andkorzh/FPGA-DENDY-SE/README.md

# FPGA-DENDY-SE
A clock-precise FPGA design for an 8-bit game console.
A simplified version of the 8-bit FPGA gaming console based on the Cyclone I EP1C3T100C8. It supports composite video output (composite encoder by NardWareMan) and optional RGB with an additional expansion board. Audio output is provided via PWM modulators.

SE_PCB

fpga_dendy_SE1

fpga_dendy_SE2

FPGA resources

se_res

video on YouTube: https://www.youtube.com/watch?v=lXBCwr5WWws
