andkorzh/FPGA-DENDY-SE/PCB/FPGA_DENDY SE.png

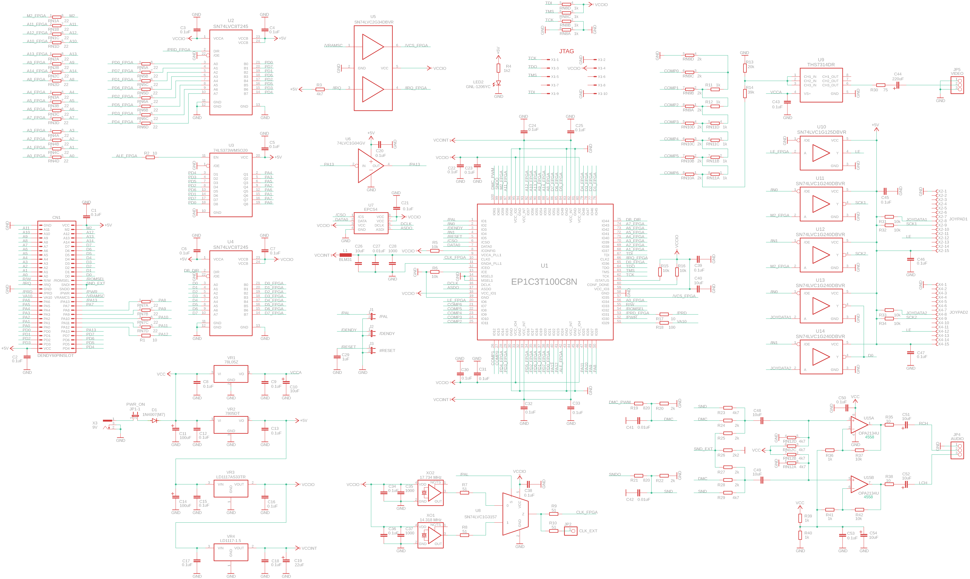
PCB/FPGA_DENDY SE.png
