andkorzh/FPGA-DENDY-SE/PCB/BOM FPGA_DENDY SE.xlsx

POS | Q-ty | VALUE | manufacturer | package | PART NUM | SIMILAR
 | 1 | EP1C3T100C8N | Altera INTEL | TQFP100 | EP1C3T100C8N | EP1C3T100I8N
 | 1 | EPCS4SI8N | Altera INTEL | SOIC-8 | EPCS4SI8N | W25X40CLSNIG
 | 2 | SN74LVC8T245PWR | TI | TSSOP-24 | SN74LVC8T245PWR | SN74LVC4245APWR
 | 1 | SN74LS373DW | TI | soic-20(7.5мм) | SN74LS373DW
 | 4 | SN74LVC1G240DBVR | TI | SOT-23-5 | SN74LVC1G240DBVR
 | 1 | SN74LVC1G125DBVR | TI | SOT-23-5 | SN74LVC1G125DBVR
 | 1 | SN74LVC1G04DBVR | TI | SOT-23-5 | SN74LVC1G04DBVR
 | 1 | SN74LVC2G34DBVR | TI | SOT-23-6 | SN74LVC2G34DBVR
 | 1 | SN74LVC1G3157DBVR | TI | SOT-23-6 | SN74LVC1G3157DBVR
 | 1 | THS7314DR | TI | SOIC-8 | THS7314DR
 | 1 | BA4558F-E2 | Rohm | SOIC-8 | BA4558F-E2
 | 1 | UMW 78M05 | UMW | DPAK/TO-252 | UMW 78M05
 | 1 | AMS1117-1.5 | UMW | SOT-223 | AMS1117-1.5 | LD1117-1.5
 | 1 | LD1117AS33TR | STM | SOT-223 | LD1117AS33TR
 | 1 | 78L05 | TI | TO-92 | LM78L05ACZ/NOPB
 | 1 | SMA4007 | UMW | DO-214AC/SMA | 1N4007(M7)
 | 1 | crystal oscillator 14.318MHz |  | 7050
 | 1 | crystal oscillator 17.734MHz |  | 7050
 | 1 | GNL-1206YC | G-nor Electronics | 1206 | GNL-1206YC | any 1206 SMD LED (YELLOW)
 | 2 | 4х1kΩ1% | Bourns | 0603x4 | CAT16-102J4LF
 | 2 | 4х2kΩ1% | Bourns | 0603x4 | CAT16-202J4LF
 | 7 | 4х22Ω1% | Bourns | 0603x4 | CAT16-22R0F4LF
 | 1 | 4х4k7kΩ5% | Bourns | 0603x4 | CAT16-472J4LF
 | 1 | 75Ω±5% | YAGEO | 0603 | RC0603JR-0775RL
 | 4 | 51Ω±5% | YAGEO | 0603 | RC0603JR-0751RL
 | 5 | 10Ω±5% | YAGEO | 0603 | RC0603JR-0710RL
 | 1 | 1,2kΩ±5% | YAGEO | 0603 | RC0603JR-071K2L
 | 1 | 2,2kΩ±1% | KOA Speer | 0603 | SG73P1JTTD2201F
 | 6 | 2kΩ±1% | KOA Speer | 0603 | RK73G1JTTD2001F
 | 6 | 1kΩ±1% | KOA Speer | 0603 | RK73G1JTTD1001F
 | 1 | 20kΩ±1% | KOA Speer | 0603 | RK73H1JTTD2002F
 | 1 | 39kΩ±1% | KOA Speer | 0603 | RK73H1JTTD3902F
 | 3 | 4,7kΩ±5% | YAGEO | 0603 | RC0603JR-074K7L
 | 10 | 10kΩ±5% | YAGEO | 0603 | RC0603JR-0710KL
 | 2 | 820Ω±1% | KOA Speer | 0603 | RK73H1JTTD8200F
 | 1 | 100Ω±5% | YAGEO | 0603 | RC0603JR-07100RL
 | 1 | 1uF X7R 16V 10% | Murata | 0603 | GRM188R71C105KA12D
 | 36 | 0.1uF X7R 16V 10% | Murata | 0603 | GRM188R71C104KA01D
 | 3 | 0.01uF X7R 16V 10% | Murata | 0603 | GRM1885C1H103JA01D
 | 3 | 1000pF NP0 50V 5% 0603 | Murata | 0603 | GRM1885C1H102J
 | 9 | 10uF X7R 10% 25V 1210, | Murata | 1210 | GRM32DR71E106KA12L
 | 2 | 100uF, 16v, 105°C, 20% ECAP SMD, 6.3x5.4мм, | JB cap | 6.3x5.4 | JCK1C101M063054
 | 1 | KLS1-DC-005A-2.0 | KLS electronic co ltd | 2,1х5.5x9mm | L-KLS1-DC-005A-2.0
