andkorzh/FPGA-DENDY-SE/PCB/FPGA_DENDY_SE.sch

## EAGLE design PCB/FPGA_DENDY_SE.sch (2026-10-07)

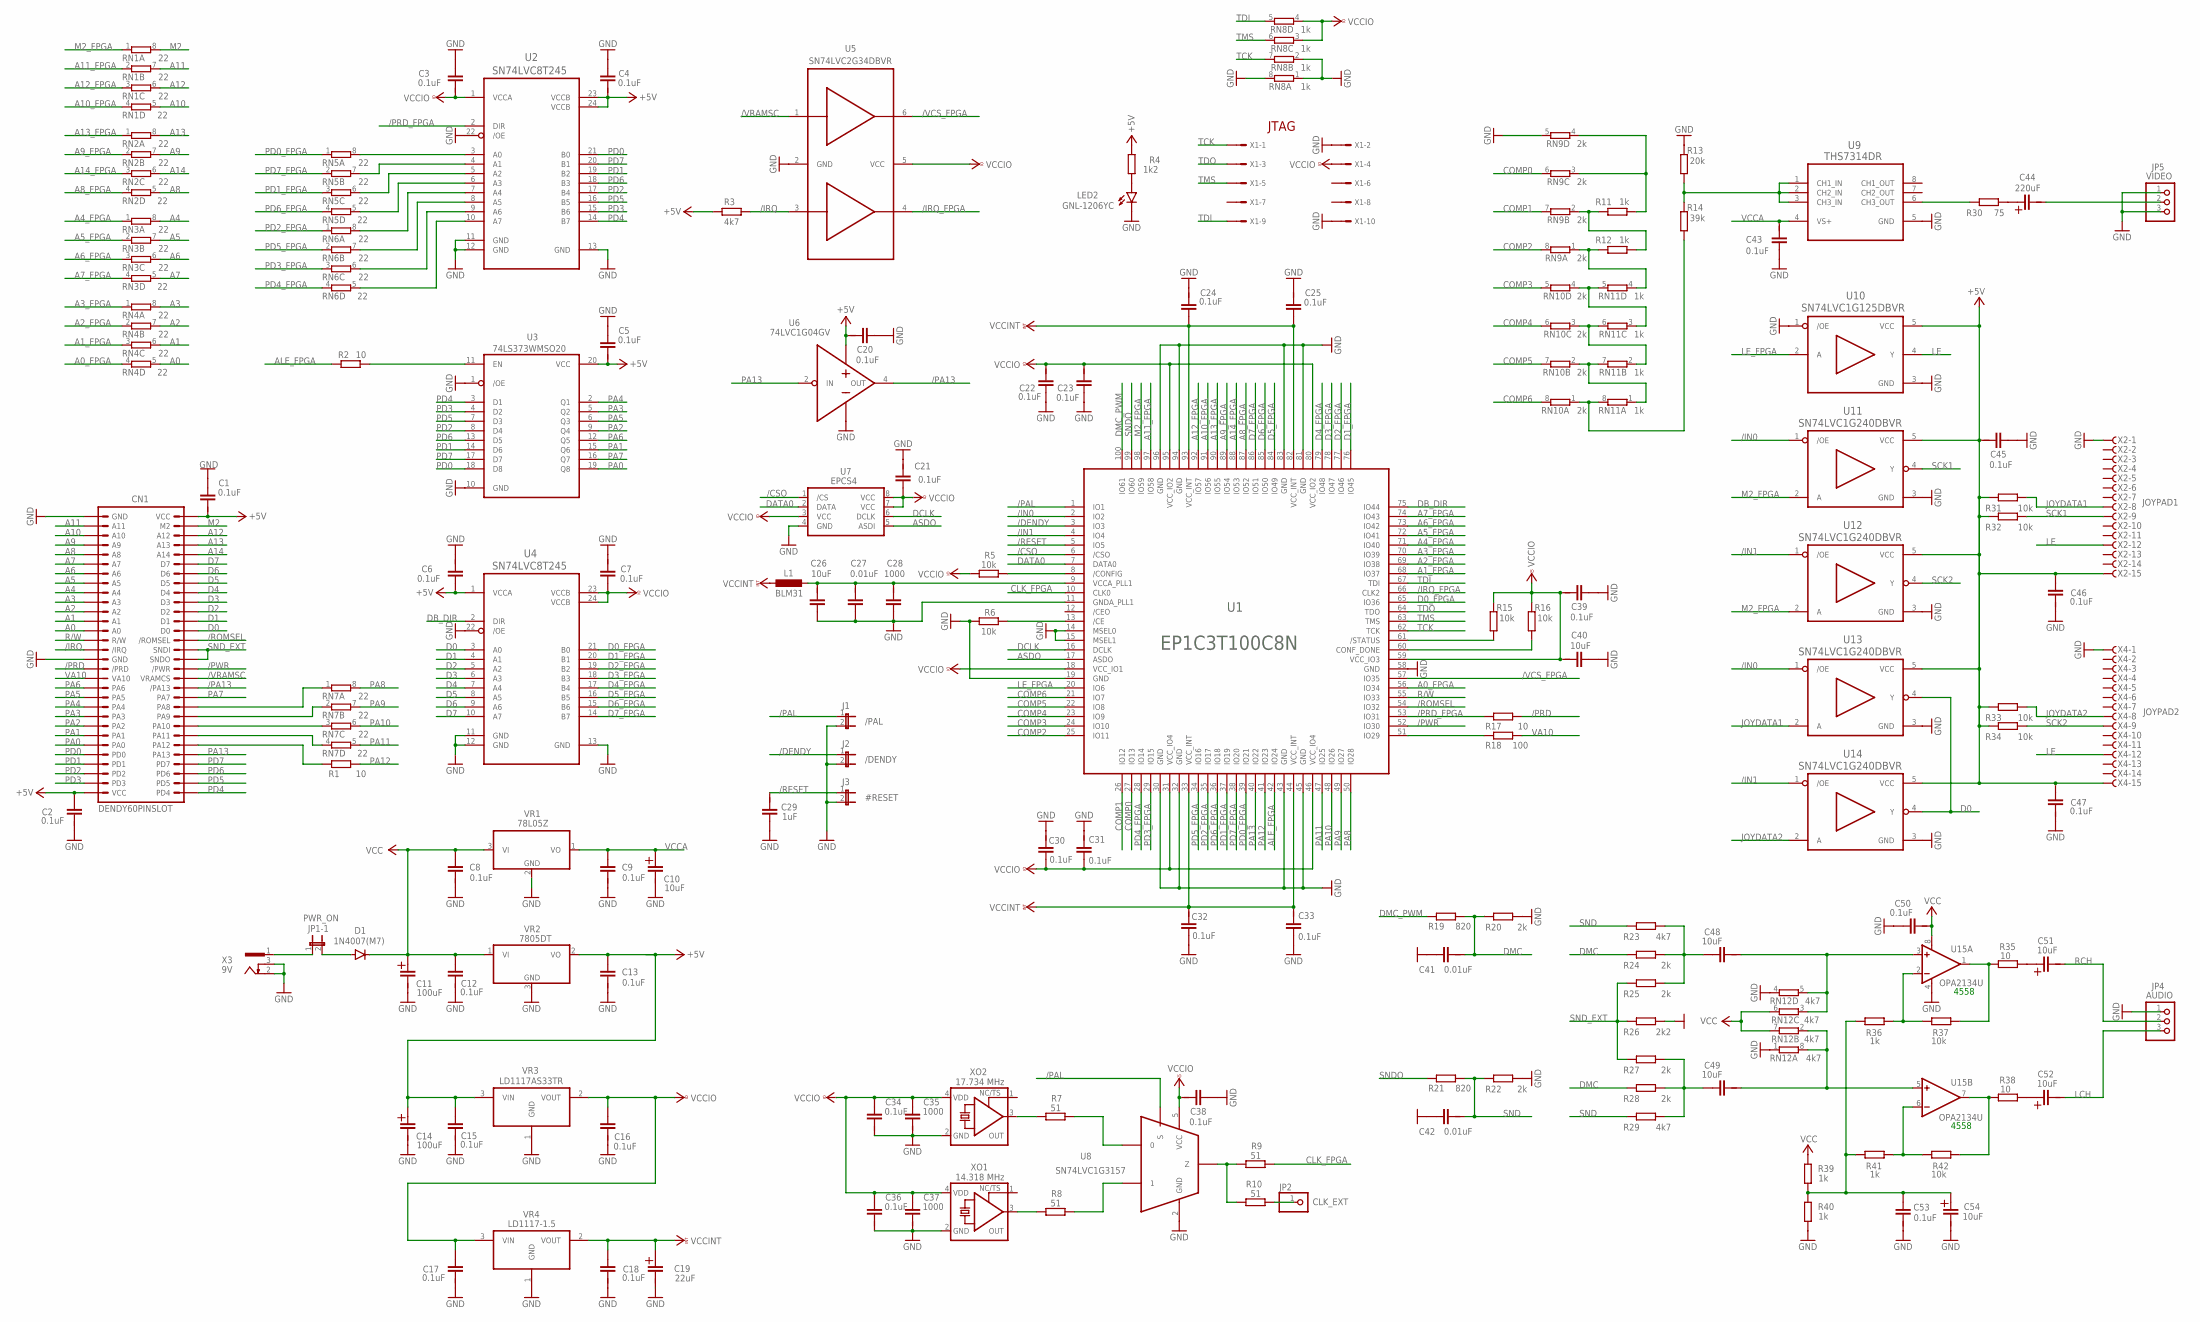
[picture p2: schematic FPGA_DENDY_SE.sch]

Parts:
C1, C2, C3, C4, C5, C8, C9, C12, C13, C15, C16, C17, C18, C34, C36, C46, C47, C50, C53: 0.1uF; C0805
C6, C7, C20, C21, C22, C23, C24, C25, C30, C31, C32, C33, C38, C39, C43, C45: 0.1uF; C0603
C10, C51, C52, C54: 10uF; 153CLV-0505
C11, C14: 100uF; 153CLV-0505
C19: 22uF; 153CLV-0505
C26, C40: 10uF; C0603
C27: 0.01uF; C0603
C28: 1000; C0603
C29: 1uF; C0603
C35, C37: 1000; C0805
C41, C42: 0.01uF; C0805
C44: 220uF; 153CLV-0505
C48, C49: 10uF; C0805
CN1: DENDY60PINSLOT; 60PINDENDY
D1: 1N4007(M7); DO-214AC
J1: /PAL; JP1
J2: /DENDY; JP1
J3: #RESET; JP1
JP1: PWR_ON; JP4Q
JP2: CLK_EXT; 1X01
JP4: AUDIO; 1X03
JP5: VIDEO; 1X03
L1: BLM31; L0201
LED2: GNL-1206YC; SML1206
R1, R2, R17, R35, R38: 10; R0805
R3, R23, R29: 4k7; R0805
R4: 1k2; R0805
R5, R6, R15, R16, R31, R32, R33, R34, R37, R42: 10k; R0805
R7, R8, R9, R10: 51; R0805
R11, R12, R36, R39, R40, R41: 1k; R0805
R13: 20k; R0805
R14: 39k; R0805
R18: 100; R0805
R19, R21: 820; R0805
R20, R22, R24, R25, R27, R28: 2k; R0805
R26: 2k2; R0805
R30: 75; R0805
RN1, RN2, RN3, RN4, RN5, RN6, RN7: 22; 0603-ARC
RN8, RN11: 1k; 0603-ARC
RN9, RN10: 2k; 0603-ARC
RN12: 4k7; 0603-ARC
U1: EP1C3T100C8N; QFP50P1600X1600X120-100N
U2, U4: SN74LVC8T245; SOP65P640X110-24N
U3: 74LS373WMSO20; SO20W
U5: SN74LVC2G34DBVR; SOT-23-6
U6: 74LVC1G04GV; SOT95P275X110-5N
U7: EPCS4; SO08
U8: SN74LVC1G3157; SOT-23-6
U9: THS7314DR; SO8
U10: SN74LVC1G125DBVR; SOT95P280X145-5N
U11, U12, U13, U14: SN74LVC1G240DBVR; SOT95P280X145-5N
U15: OPA2134U; SO08
VR1: 78L05Z; TO92
VR2: 7805DT; TO252
VR3: LD1117AS33TR; SOT230P700X180-4N
VR4: LD1117-1.5; SOT-223-3
X1: 057-010-1
X2: JOYPAD1; F15HP
X3: 9V; 733980-62
X4: JOYPAD2; F15HP
XO1: 14.318 MHz; 7.0X5.08_KXO-(V)97
XO2: 17.734 MHz; 2.5X2.0_KXO-V95

Connections:
+5V: C1.2, C2.1, C4.2, C5.2, C6.1, C13.1, C14.+, C15.1, C20.2, C45.2, C46.1, C47.1, CN1.A30 (VCC), CN1.B1 (VCC), R3.1, R4.2, R31.1, R32.1, R33.1, R34.1, U2.23 (VCCB), U2.24 (VCCB), U3.20 (VCC), U4.1 (VCCA), U6.5 (VCC), U10.5 (VCC), U11.5 (VCC), U12.5 (VCC), U13.5 (VCC), U14.5 (VCC), VR2.2 (VO), VR3.3 (VIN), X2.15 (F), X4.15 (F)
/CSO: U1.6 (/CSO), U7.1 (/CS)
/DENDY: J2.1, U1.3 (IO3)
/IN0: U1.2 (IO2), U11.1 (/OE), U13.1 (/OE)
/IN1: U1.4 (IO4), U12.1 (/OE), U14.1 (/OE)
/IRQ: CN1.A15 (/IRQ), R3.2, U5.3 (IN2)
/IRQ_FPGA: U1.66 (CLK2), U5.4 (OUT2)
/PA13: CN1.B19 (/PA13), U6.4 (OUT)
/PAL: J1.1, U1.1 (IO1), U8.6 (S)
/PRD: CN1.A17 (/PRD), R17.2
/PRD_FPGA: R17.1, U1.53 (IO31), U2.2 (DIR)
/PWR: CN1.B17 (/PWR), U1.52 (IO30)
/PWR_FPGA: R18.1, U1.51 (IO29)
/RESET: C29.2, J3.1, U1.5 (IO5)
/ROMSEL: CN1.B14 (/ROMSEL), U1.54 (IO32)
/VCS_FPGA: U1.57 (IO35), U5.6 (OUT1)
/VRAMSC: CN1.B18 (VRAMCS), U5.1 (IN1)
A0: CN1.A13 (A0), RN4.5 (2)
A0_FPGA: RN4.4 (1), U1.56 (IO34)
A1: CN1.A12 (A1), RN4.6 (2)
A1_FPGA: RN4.3 (1), U1.68 (IO37)
A2: CN1.A11 (A2), RN4.7 (2)
A2_FPGA: RN4.2 (1), U1.69 (IO38)
A3: CN1.A10 (A3), RN4.8 (2)
A3_FPGA: RN4.1, U1.70 (IO39)
A4: CN1.A9 (A4), RN3.8 (2)
A4_FPGA: RN3.1, U1.71 (IO40)
A5: CN1.A8 (A5), RN3.7 (2)
A5_FPGA: RN3.2 (1), U1.72 (IO41)
A6: CN1.A7 (A6), RN3.6 (2)
A6_FPGA: RN3.3 (1), U1.73 (IO42)
A7: CN1.A6 (A7), RN3.5 (2)
A7_FPGA: RN3.4 (1), U1.74 (IO43)
A8: CN1.A5 (A8), RN2.5 (2)
A8_FPGA: RN2.4 (1), U1.87 (IO52)
A9: CN1.A4 (A9), RN2.7 (2)
A9_FPGA: RN2.2 (1), U1.89 (IO54)
A10: CN1.A3 (A10), RN1.5 (2)
A10_FPGA: RN1.4 (1), U1.91 (IO56)
A11: CN1.A2 (A11), RN1.7 (2)
A11_FPGA: RN1.2 (1), U1.97 (IO58)
A12: CN1.B3 (A12), RN1.6 (2)
A12_FPGA: RN1.3 (1), U1.92 (IO57)
A13: CN1.B4 (A13), RN2.8 (2)
A13_FPGA: RN2.1, U1.90 (IO55)
A14: CN1.B5 (A14), RN2.6 (2)
A14_FPGA: RN2.3 (1), U1.88 (IO53)
ALE_FPGA: R2.1, U1.42 (IO24)
ASDO: U1.17 (ASDO), U7.5 (ASDI)
CLK_FPGA: R9.2, U1.10 (CLK0)
COMP0: RN9.6 (2), U1.27 (IO13)
COMP1: RN9.7 (2), U1.26 (IO12)
COMP2: RN9.8 (2), U1.25 (IO11)
COMP3: RN10.5 (2), U1.24 (IO10)
COMP4: RN10.6 (2), U1.23 (IO9)
COMP5: RN10.7 (2), U1.22 (IO8)
COMP6: RN10.8 (2), U1.21 (IO7)
D0: CN1.B13 (D0), U4.3 (A0), U13.4 (Y), U14.4 (Y)
D0_FPGA: U1.65 (IO36), U4.21 (B0)
D1: CN1.B12 (D1), U4.4 (A1)
D1_FPGA: U1.76 (IO45), U4.20 (B1)
D2: CN1.B11 (D2), U4.5 (A2)
D2_FPGA: U1.77 (IO46), U4.19 (B2)
D3: CN1.B10 (D3), U4.6 (A3)
D3_FPGA: U1.78 (IO47), U4.18 (B3)
D4: CN1.B9 (D4), U4.7 (A4)
D4_FPGA: U1.79 (IO48), U4.17 (B4)
D5: CN1.B8 (D5), U4.8 (A5)
D5_FPGA: U1.84 (IO49), U4.16 (B5)
D6: CN1.B7 (D6), U4.9 (A6)
D6_FPGA: U1.85 (IO50), U4.15 (B6)
D7: CN1.B6 (D7), U4.10 (A7)
D7_FPGA: U1.86 (IO51), U4.14 (B7)
DATA0: U1.7 (DATA0), U7.2 (DATA)
DB_DIR: U1.75 (IO44), U4.2 (DIR)
DCLK: U1.16 (DCLK), U7.6 (DCLK)
DMC: C41.2, R19.2, R20.1, R24.1, R28.1
DMC_PWM: R19.1, U1.100 (IO61)
GND: C1.1, C2.2, C3.1, C4.1, C5.1, C6.2, C7.2, C8.2, C9.2, C10.-, C11.-, C12.2, C13.2, C14.-, C15.2, C16.2, C17.2, C18.2, C19.-, C20.1, C21.2, C22.1, C23.1, C24.2, C25.2, C26.1, C27.1, C28.1, C29.1, C30.2, C31.2, C32.1, C33.1, C34.2, C35.2, C36.2, C37.2, C38.1, C39.1, C40.1, C41.1, C42.1, C43.1, C45.1, C46.2, C47.2, C50.1, C53.2, C54.-, CN1.A1 (GND), CN1.A16 (GND), J1.2, J2.2, J3.2, JP4.1, JP5.1, JP5.3, LED2.C, R6.1, R13.2, R20.2, R22.2, R26.2, R40.2, RN8.1, RN8.2 (1), RN8.8 (2), RN9.5 (2), RN12.1, RN12.4 (1), U1.11 (GNDA_PLL1), U1.14 (MSEL0), U1.15 (MSEL1), U1.19 (GND), U1.30 (GND), U1.32 (GND), U1.43 (GND), U1.45 (GND), U1.58 (GND), U1.81 (GND), U1.83 (GND), U1.94 (GND), U1.96 (GND), U2.11 (GND), U2.12 (GND), U2.13 (GND), U2.22 (/OE), U3.1 (/OE), U3.10 (GND), U4.11 (GND), U4.12 (GND), U4.13 (GND), U4.22 (/OE), U5.2 (GND), U6.3 (GND), U7.4 (GND), U8.2 (GND), U9.5 (GND), U10.1 (/OE), U10.3 (GND), U11.3 (GND), U12.3 (GND), U13.3 (GND), U14.3 (GND), U15.4 (V-), VR1.2 (GND), VR2.3 (GND), VR3.1 (GND), VR4.1 (GND), X1.2, X1.10, X2.1 (F), X3.2, X3.3, X4.1 (F), XO1.2 (GND), XO2.2 (GND)
JOYDATA1: R31.2, U13.2 (A), X2.8 (F)
JOYDATA2: R33.2, U14.2 (A), X4.8 (F)
LCH: C52.-, JP4.3
LE: U10.4 (Y), X2.12 (F), X4.12 (F)
LE_FPGA: U1.20 (IO6), U10.2 (A)
M2: CN1.B2 (M2), RN1.8 (2)
M2_FPGA: RN1.1, U1.98 (IO59), U11.2 (A), U12.2 (A)
unnamed: R15.1, U1.61 (/STATUS)
unnamed: R16.1, U1.60 (CONF_DONE)
unnamed: JP2.1, R10.2
unnamed: RN10.2 (1), RN11.1, RN11.7 (2)
unnamed: R11.2, RN9.3 (1), RN9.4 (1)
unnamed: R2.2, U3.11 (EN)
unnamed: RN5.8 (2), U2.3 (A0)
unnamed: R12.1, RN9.1, RN11.4 (1)
unnamed: RN10.3 (1), RN11.2 (1), RN11.6 (2)
unnamed: R6.2, U1.13 (/CE)
unnamed: R5.2, U1.8 (/CONFIG)
unnamed: C26.2, C27.2, C28.2, L1.2, U1.9 (VCCA_PLL1)
unnamed: C52.+, R38.2
unnamed: R41.2, R42.1, U15.6 (-IN)
unnamed: D1.A, JP1.2
unnamed: C48.1, R23.2, R24.2, R25.2
unnamed: R8.1, XO1.3 (OUT)
unnamed: R7.1, XO2.3 (OUT)
unnamed: RN5.7 (2), U2.4 (A1)
unnamed: RN5.6 (2), U2.5 (A2)
unnamed: RN5.5 (2), U2.6 (A3)
unnamed: RN6.8 (2), U2.7 (A4)
unnamed: RN6.7 (2), U2.8 (A5)
unnamed: RN6.6 (2), U2.9 (A6)
unnamed: RN6.5 (2), U2.10 (A7)
unnamed: R11.1, R12.2, RN9.2 (1)
unnamed: CN1.B21 (PA8), RN7.1
unnamed: R14.1, RN10.1, RN11.8 (2)
unnamed: CN1.B22 (PA9), RN7.2 (1)
unnamed: C49.1, R27.2, R28.2, R29.2
unnamed: CN1.B23 (PA10), RN7.3 (1)
unnamed: CN1.B24 (PA11), RN7.4 (1)
unnamed: CN1.B25 (PA12), R1.1
unnamed: R30.1, U9.6 (CH3_OUT)
unnamed: R7.2, U8.3 (0)
unnamed: C44.+, R30.2
unnamed: C51.+, R35.2
unnamed: C48.2, RN12.3 (1), RN12.5 (2), U15.3 (+IN)
unnamed: C49.2, RN12.2 (1), RN12.8 (2), U15.5 (+IN)
unnamed: RN10.4 (1), RN11.3 (1), RN11.5 (2)
unnamed: R13.1, R14.2, U9.1 (CH1_IN), U9.2 (CH2_IN), U9.3 (CH3_IN)
unnamed: R36.2, R37.1, U15.2 (-IN)
unnamed: R35.1, R37.2, U15.1 (OUT)
unnamed: R38.1, R42.2, U15.7 (OUT)
unnamed: C44.-, JP5.2
unnamed: R8.2, U8.1
unnamed: R9.1, R10.1, U8.4 (Z)
unnamed: LED2.A, R4.1
unnamed: JP1.1, X3.1
PA0: CN1.A25 (PA0), U3.19 (Q8)
PA1: CN1.A24 (PA1), U3.15 (Q6)
PA2: CN1.A23 (PA2), U3.9 (Q4)
PA3: CN1.A22 (PA3), U3.5 (Q2)
PA4: CN1.A21 (PA4), U3.2 (Q1)
PA5: CN1.A20 (PA5), U3.6 (Q3)
PA6: CN1.A19 (PA6), U3.12 (Q5)
PA7: CN1.B20 (PA7), U3.16 (Q7)
PA8: RN7.8 (2), U1.50 (IO28)
PA9: RN7.7 (2), U1.49 (IO27)
PA10: RN7.6 (2), U1.48 (IO26)
PA11: RN7.5 (2), U1.47 (IO25)
PA12: R1.2, U1.41 (IO23)
PA13: CN1.B26 (PA13), U1.40 (IO22), U6.2 (IN)
PD0: CN1.A26 (PD0), U2.21 (B0), U3.18 (D8)
PD0_FPGA: RN5.1, U1.39 (IO21)
PD1: CN1.A27 (PD1), U2.19 (B2), U3.14 (D6)
PD1_FPGA: RN5.3 (1), U1.37 (IO19)
PD2: CN1.A28 (PD2), U2.17 (B4), U3.8 (D4)
PD2_FPGA: RN6.1, U1.35 (IO17)
PD3: CN1.A29 (PD3), U2.15 (B6), U3.4 (D2)
PD3_FPGA: RN6.3 (1), U1.29 (IO15)
PD4: CN1.B30 (PD4), U2.14 (B7), U3.3 (D1)
PD4_FPGA: RN6.4 (1), U1.28 (IO14)
PD5: CN1.B29 (PD5), U2.16 (B5), U3.7 (D3)
PD5_FPGA: RN6.2 (1), U1.34 (IO16)
PD6: CN1.B28 (PD6), U2.18 (B3), U3.13 (D5)
PD6_FPGA: RN5.4 (1), U1.36 (IO18)
PD7: CN1.B27 (PD7), U2.20 (B1), U3.17 (D7)
PD7_FPGA: RN5.2 (1), U1.38 (IO20)
R/W: CN1.A14 (R/W), U1.55 (IO33)
RCH: C51.-, JP4.2
SCK1: R32.2, U11.4 (Y), X2.9 (F)
SCK2: R34.2, U12.4 (Y), X4.9 (F)
SND: C42.2, R21.2, R22.1, R23.1, R29.1
SNDO: R21.1, U1.99 (IO60)
SND_EXT: CN1.B15 (SNDI), CN1.B16 (SNDO), R25.1, R26.1, R27.1
TCK: RN8.7 (2), U1.62 (TCK), X1.1
TDI: RN8.5 (2), U1.67 (TDI), X1.9
TDO: U1.64 (TDO), X1.3
TMS: RN8.6 (2), U1.63 (TMS), X1.5
VA10: CN1.A18 (VA10), R18.2
VCC: C8.1, C11.+, C12.1, C50.2, D1.C, R39.1, RN12.6 (2), RN12.7 (2), U15.8 (V+), VR1.3 (VI), VR2.1 (VI)
VCCA: C9.1, C10.+, C43.2, U9.4 (VS+), VR1.1 (VO)
VCCINT: C18.1, C19.+, C24.1, C25.1, C32.2, C33.2, L1.1, U1.33 (VCC_INT), U1.44 (VCC_INT), U1.82 (VCC_INT), U1.93 (VCC_INT), VR4.2 (VOUT)
VCCIO: C3.2, C7.1, C16.1, C17.1, C21.1, C22.2, C23.2, C30.1, C31.1, C34.1, C35.1, C36.1, C37.1, C38.2, C39.2, C40.2, R5.1, R15.2, R16.2, RN8.3 (1), RN8.4 (1), U1.18 (VCC_IO1), U1.31 (VCC_IO4), U1.46 (VCC_IO4), U1.59 (VCC_IO3), U1.80 (VCC_IO2), U1.95 (VCC_IO2), U2.1 (VCCA), U4.23 (VCCB), U4.24 (VCCB), U5.5 (VCC), U7.3 (VCC), U7.7 (VCC), U7.8 (VCC), U8.5 (VCC), VR3.2 (VOUT), VR4.3 (VIN), X1.4, XO1.4 (VDD), XO2.4 (VDD)
VPPL3: C53.1, C54.+, R36.1, R39.2, R40.1, R41.1

Notes on the sheet:
JTAG
4558
